Chouliar/BeeHiveScaleV.1/Fabrication/349207536_1639754129873747_4320279225657180878_n.jpg

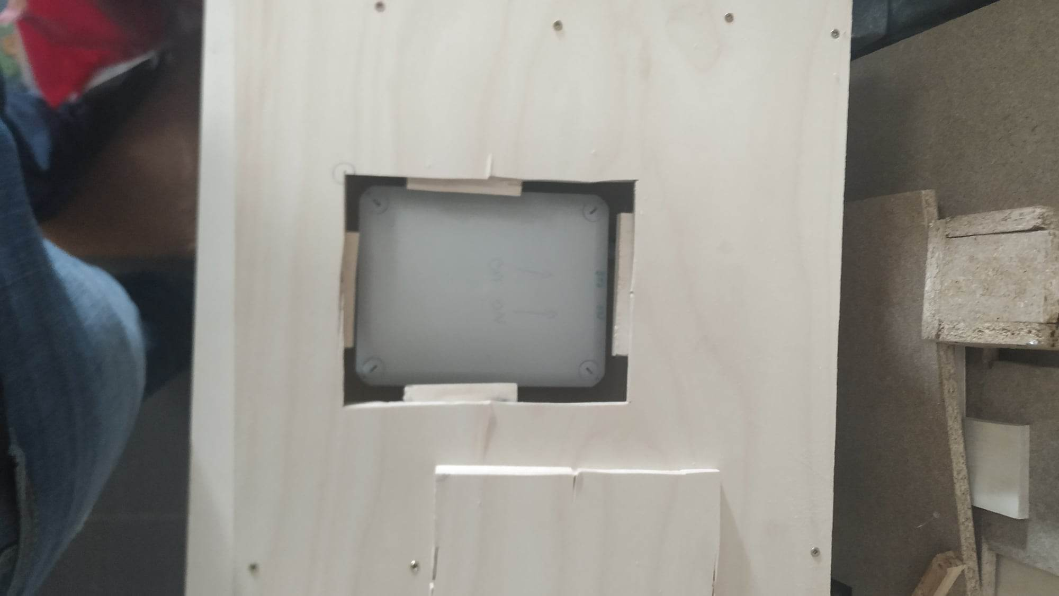
Fabrication/349207536_1639754129873747_4320279225657180878_n.jpg
