Chouliar/BeeHiveScaleV.1/Fabrication/349413017_263348282845386_3138476883546079525_n.jpg

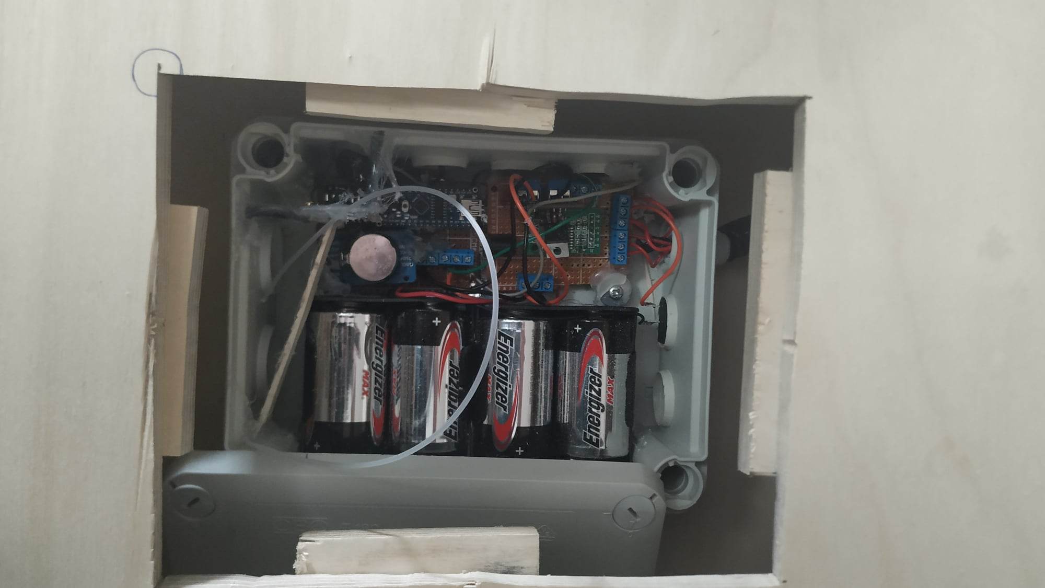
Fabrication/349413017_263348282845386_3138476883546079525_n.jpg
