Chouliar/BeeHiveScaleV.1/README.md

# BeeHiveScaleV.1
Version 1.0 of a BeeHive Scale based on Arduino. Code and report(in Greek)

A bee scale based on Arduino that uses HX711 + 4 load cells + GSM800L module + DC3231 RTC

Used in Arduino Code: 

“HX711 Library.” Creator: GitHub User “R. Tillaart”,
https://github.com/RobTillaart/HX711

“Low-Power Library.” Creator: GitHub User “rocketscream”,
https://github.com/rocketscream/Low-Power

“Arduino DS3232RTC Library.” Creator: J. Christensen,
https://github.com/JChristensen/DS3232RTC
