Chouliar/BeeHiveScaleV.1/Fabrication/348377718_3496599863930502_8176121339687399203_n.jpg

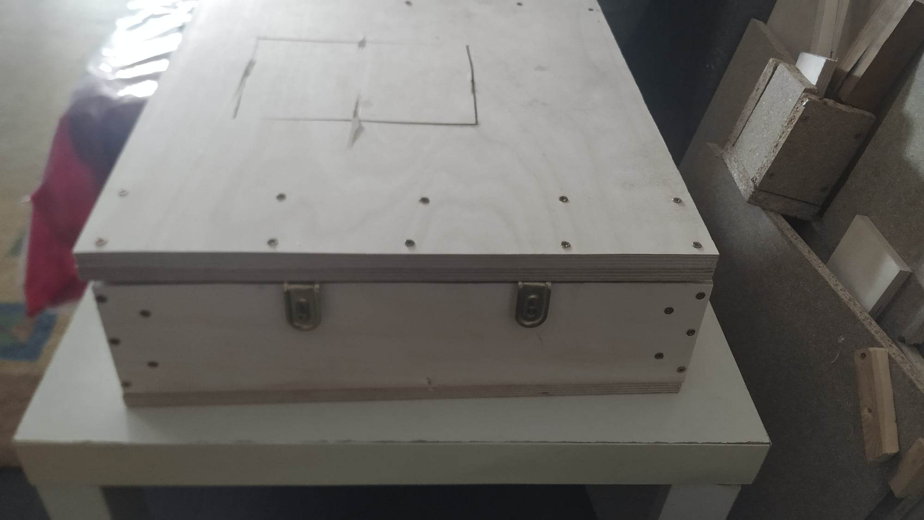
Fabrication/348377718_3496599863930502_8176121339687399203_n.jpg
