Chouliar/BeeHiveScaleV.1/Fabrication/349232444_604518074990279_6505185452723002283_n.jpg

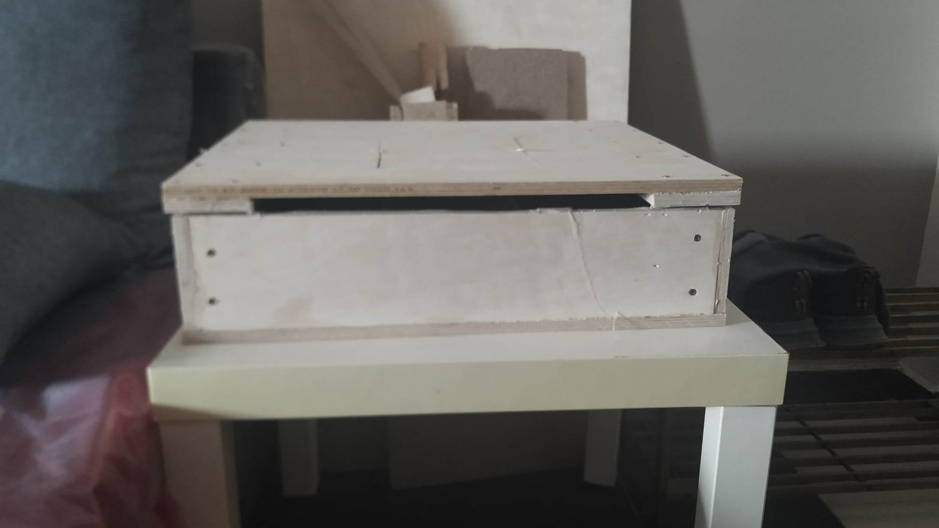
Fabrication/349232444_604518074990279_6505185452723002283_n.jpg
