Chouliar/BeeHiveScaleV.1/Fabrication/IMG_20210125_205650.jpg

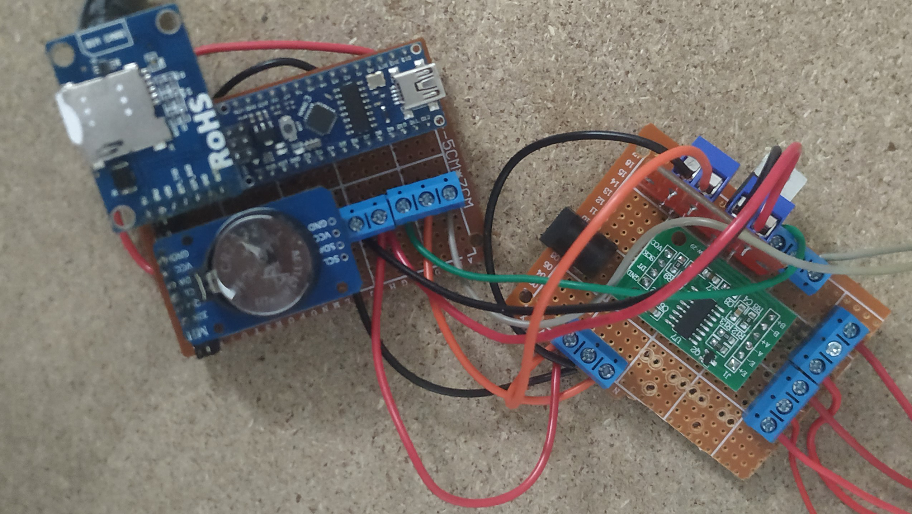
Fabrication/IMG_20210125_205650.jpg
